nsolomon925/LiDAR-Distance-Measurement-System/README.md

# LiDAR-Distance-Measurement-System
A portable, battery-powered distance measurement solution designed for precision and real-time feedback. This project integrates an ATmega 2560 microcontroller with a TF-Luna LiDAR sensor using the I2C communication protocol to provide high-frequency distance data.

## 📺 Project Demonstration
LiDAR System Demo (https://www.youtube.com/watch?v=DX2tLfPNf9k)

*Click the image above to watch the system in action.*

## 🚀 Key Features
* **Real-Time Processing:** High-speed data acquisition from the TF-Luna sensor.
* **Visual Output:** Integrated **1602 LCD** for clear, instant distance readouts.
* **Rugged Portability:** Housed in a durable ammo box casing, making it suitable for field testing.
* **Optimized Power:** Designed as a standalone, battery-powered unit for mobile use.

## 🛠️ Technical Specifications
* **Microcontroller:** ATmega 2560.
* **Sensor:** TF-Luna LiDAR (via I2C communication).
* **Display:** 1602 LCD with I2C integration.
* **Software:** Custom logic for sensor calibration and data smoothing.

## 📂 Repository Structure
* **`Lidar_System/`**: Contains the `.ino` source code for the ATmega 2560.
* **`docs/`**: Includes the full technical report and design review presentation slides.
