nsolomon925/LiDAR-Distance-Measurement-System/(commit log)

2026-03-24 Initial commit of LiDAR measurement firmware for ATmega 2560
    Integrated TF-Luna sensor with ATmega 2560 using I2C communication. Includes logic for pushbutton-triggered distance acquisition and 1602 LCD output formatting.
2026-03-24 Upload technical project documentation and hardware report
    Includes full system overview, Bill of Materials (BOM), I2C communication theory, and hardware troubleshooting for the ATmega 2560 LiDAR system.
2026-03-24 Add technical project report for ATmega 2560 LiDAR system
    Includes hardware specifications, I2C communication logic for the TF-Luna sensor, 1602 LCD integration, and circuit troubleshooting documentation.
2026-03-24 Add system architecture and design review presentation
    Visual overview of the LiDAR Distance Measurement System, featuring the ATmega 2560 control logic, TF-Luna sensor integration via I2C, and final hardware assembly.
2026-03-24 docs: add YouTube demonstration of LiDAR system
    Included a video link in the README showing real-time distance measurements and 1602 LCD output using the TF-Luna sensor. Visual tests demonstrate accuracy from 30cm up to 296cm.
